freesurfer-rge/slothpu/pcbs/python-testing/ReadMe.md

# Board Testers

This directory contains Python code to test each board independently.
As such, runs should always be performed on a single test file at a time.
For example:

```bash
python -m pytest test_tester_board.py
```
