freesurfer-rge/slothpu/(threads)

Thread 26 (2022-10-15):

Assembler belongs in slothpu

freesurfer-rge, 2022-10-15:
Most of the assembler really belongs in the `slothpu` package. The current script should be a thin caller into the refactored code (as should the `run_slothpu.py` script).

freesurfer-rge, 2022-10-16:
Done

Closed 2022-10-16.

Thread 40 (2022-10-23):

[BUG] Fibonacci comments incorrect

freesurfer-rge, 2022-10-23:
The comments laying out the stack frame have `F(n-1)` twice, rather than `F(n-2)`

Thread 46 (2023-03-16):

[PCB] DALU r1 Decode

freesurfer-rge, 2023-03-16:
The rev1 of the DALU board has the outputs from the instruction decoder connected backwards (i.e. 'ADD' is 111 rather than 000). This can be 'fixed' by adjusting the instructions stored, but should be corrected when the board is revised.

Thread 47 (2023-03-16):

[PCB] Tester board bad voltage shifter

freesurfer-rge, 2023-03-16:
The voltage shifter (U202) for the `IN_{DATA}` line is connected incorrectly. All of the other 'A' side pins should be pulled low, not the 'B' side ones. This is causing the IC to run very hot.

Closed 2023-04-27.

Thread 52 (2023-09-09):

[PCB] SALU r1 Decode

freesurfer-rge, 2023-09-09:
Working through testing, find:

- 'NOT' and 'COPY' are swapped

Thread 57 (2023-10-07):

Future Thoughts

freesurfer-rge, 2023-10-07:
I'm beginning to wonder if this design is the right way to go. The design is gaining complexity because I am trying to force things into 8-bit buses when instructions and addressing are 16-bit.

A fully 8-bit design isn't really practical:

- Too small an address space
- Very hard to fit all the instructions in

The mixed design gets complicated because:

- The C bus is sometimes used for writing, sometimes for reading
- Have to combine registers to generate addresses
- PC needs a jump register
- Loading the next instruction takes two steps

In this specific design, I have also probably made the PC too complicated with lots of instructions.... in part because needing to combine registers to create addresses makes the effective register count lower.

I'm not sure that I have a good ALU design. I think there are too many bitwise operations and shifts. Also, the 'flag' line isn't really necessary. I think a more useful ALU (no separation into SALU and DALU) would be:

- Add
- Subtract
- Compare (using comparators, so 3-bits in the output)
- NAND
- LSHIFT0
- LBARREL

One final point: since I'm using SMD assembly for a lot of this, going to a fully 16-bit design wouldn't actually double the assembly work. This is because JLCPCB requires at least two boards be assembled each time. With both the ALU and the register file, it should be possible to design an 8-bit board which can be chained into a 16-bit one.
