freesurfer-rge/slothpu/(commit log)

2022-10-05 Create ProgramCounter (#7)
    Create the `ProgramCounter`, some tests and the associated widget. Also start having actual execution take place as the pipeline stage advances.
2022-10-07 Add Instruction Register (#11)
    Add an `InstructionRegister` class and associated paraphernalia. I'm not sure that it is printed the most useful way in the interface, since it's really deciphered little endian. Will have to consider this some more.
2022-10-07 Add 'enable increment' to PC (#12)
    Change the `ProgramCounter` logic slightly, so that there is a flag which indicates when a command in increment should be performed. This is set to `True` by the FETCH0 pipeline stage, but is set to `False` if a branch occurs.
2022-10-07 More documentation (#13)
    Expand the documentation:
    - Describe the desired pipeline stages
    - Describe the various functional units and their associated instructions
    This does not yet get into the details of the instruction encoding.
2022-10-11 Split up `execute()` (#21)
    Rather than have the `execute()` method called whenever a functional unit is supposed to do something, have a separate method for each pipeline stage. The `execute()` method will remain for those units which need it. Have not updated the `RegisterFile` yet, since larger changes are planned.
2022-10-15 Minimal Assembler (#24)
    Create an 'assembler' script which can take a file written in SlothPU assembler (with a `#` comment character) and then output a file which can be a memory map for a SlothPU run.
    This is not yet fully implemented, but it can assemble the supplied `increment.txt` program, which should simply increment R0 in an infinite loop.
2022-10-15 Initialise main memory (#25)
    Allow initialisation of main memory from a list of integers. Modify the `run_slothpu.py` script to call into the assembler (which should probably be refactored).
2022-10-16 Initial program execution (#27)
    Put in enough structure to get a very simple program executing. This has required several changes:
    - The `InstructionRegister` now has properties for the current operation and the commit target
    - Individual functional units have to provide a `decode()` method to populate these new properties
    - The pipeline within `SlothPU` itself has been updated
    Only a few instructions have been enabled at this time. There is no automated testing of the program running either.
    Some minor documentation corrections are included.
2022-10-16 Refactor assembler and start E2E (#28)
    Refactor the main part of the assembler under `slothpu`, updating other scripts accordingly. Also add the first E2E test of SlothPU in the form of the register incrementer program.
2022-10-16 Expand assembler for new test (#29)
    Create a new program to count by five. This uses the DALU and also stores its result in main memory. Consequently, the assembler has been expanded to cope with the instructions this requires. Change the E2E tests to load the sample programs, rather than having code embedded in the test file.
2022-10-17 UX Improvements (#33)
    Some small changes:
    - Add a smoke test for the interface. This is *literally* just a smoke test
    - Add an 'Advance Instruction' button to step through a program faster
    - Start experimenting with colour for the UX
    - Have some more widget constructors call their own `update()` methods
2022-10-19 Two Byte add with subroutine (#34)
    Add another sample program which uses a proper subroutine to add two 2-byte numbers together. This has shown how fast one can run out of registers when trying to use 8-bit registers and 16-bit addresses.
    Also have some tests of the new program.
2022-10-22 Add PC BRANCH* instructions (#37)
    Adds all the `PC BRANCH*` instructions proposed in #35. In addition to the usual tests, have two extra sample programs. These modify existing programs to use branches instead of jumps.
    As noted in the docs, the operation codes for the PC do need to be looked at more closely.
    Closes #35
2022-10-23 Add Fibonacci program (#38)
    Add a sample program which computes Fibonacci numbers. This has revealed a bug in the handling of `LOADJUMP0` and `LOADJUMP1`. Include a couple of end-to-end tests.
2022-12-22 PCB Design for DALU (#42)
    Using KiCad to implement the Dual operand Arithmetic Logic Unit.
    [AddSub.kicad_sch, AndNand.kicad_sch, DALU.kicad_sch, Decoder.kicad_sch, OR.kicad_sch, and.kicad_sch, connector.kicad_sch, output.kicad_sch]
2023-01-24 Test Board (#43)
    A test board, to be driven by a Raspberry Pi. Provides 40 outputs and 40 inputs, all at 5V. Also breaks out the remaining 3.3V GPIO pins of the Raspberry Pi.
    [Tester.kicad_pcb, Tester.kicad_sch, in_registers.kicad_sch, out_registers.kicad_sch, pi_input.kicad_sch]
2023-02-12 Connector for ALU (#45)
    A board to connect the Tester board to the ALUs. I only have the DALU right now, but the SALU can use the same 2x20 connector. The other 'test point' pins on the DALU can be connected manually to all the other input pins which are broken out.
    [ALU Connector.kicad_pcb, ALU Connector.kicad_sch]
2023-03-16 Python tests for DALU (#48)
    Adding tests for the DALU board which can run with `pytest`. Note that these are for the r1 board, which has the instruction decoder outputs connected backwards.
2023-04-27 Single Operand ALU (#50)
    Adding the single operand arithmetic logic unit or SALU. This is what has been sent for the r1 manufacturing.
    [SALU.kicad_sch, barrel_shifters.kicad_sch, connector.kicad_sch, decoder.kicad_sch, incdec.kicad_sch, not_copy.kicad_sch, output_stage.kicad_sch, shifters.kicad_sch]
2023-04-27 Fix Tester board (#49)
    The 'input' level shifter on the Tester board had the wrong set of pins connected to ground (copy paste error from the 'output' level shifters). This meant that the IC could effectively short circuit and become very hot. Switch over the ground and floating pins, to reflect how the inputs and outputs are for this IC.
    Closes #47
    [Tester.kicad_pcb, Tester.kicad_sch, pi_input.kicad_sch]
2023-09-09 Add tests of SALU PCB (#53)
    Adding tests of the SALU. This should be comprehensive, since we have far fewer inputs to test. Note that #52 has been added to track issues with the instructions not corresponding to the correct bit patterns.
2023-10-07 Add Register File and Connector boards (#55)
    Add two new boards:
    - The Register File
    - Connector for testing (no blinkenlights)
    These are the r1 boards, as send for manufacturing today
    [Register File Connector.kicad_pcb, Register File Connector.kicad_sch, Register File.kicad_sch, register.kicad_sch, selectors.kicad_sch]
2023-10-22 Tester for the Register File (#59)
    Create a test suite for the Register File. As noted in Issue #58 this has uncovered the fact that the register file is updating on 'Execute' when it should be updating on 'Commit' and the tests have to reflect this.
    [selectors.kicad_sch]
